ojousima/kon-41.3131/README.md

# kon-41.3131
Aalto university student project for constant temperature controller
