ojousima/kon-41.3131/TSYS01-shield/tsys01.kicad_pcb

## KiCad design TSYS01-shield/tsys01.kicad_pcb (2015-07-23)

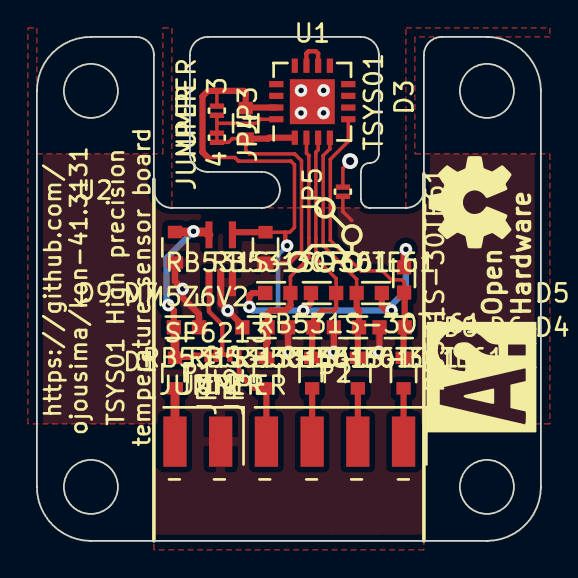
[picture p1: board tsys01.kicad_pcb from above]

Board: 2 copper layers, 28.0 x 28.0 mm, 26 parts (0 on the bottom side), 14 nets.

Parts:
C1, C2: 2u2; SMD0603_WAVE
C3: 100n; SMD0603_WAVE
D1: MM5Z6V2; SOD-523
D2, D3, D4, D5, D6, D7, D8, D9: RB531S-30TE61; SOD-523
JP1, JP2, JP3, JP4, JP5: JUMPER; R_0201
P1: CONN_01X02; Pin_Header_Angled_SMD_1x02
P2: CONN_01X04; Pin_Header_Angled_SMD_1x04
R1, R2, R3, R4, R5: 220; SMD0603_WAVE
U1: TSYS01; QFN-16-1EP_4x4mm_Pitch0.65mm
U2: SP6213; SC70-6_Handsoldering

Connections:
+3V3: C2.1, C3.1, D3.2, D5.2, D7.2, D9.2, JP3.1, U1.15, U2.4
/CS: JP2.2, P2.4, R2.1
/EN: D8.2, D9.1, R2.2, U1.2
/MISO: P2.1, R5.1
/MOSI: P2.2, R4.1
/PAD: JP5.2, U1.17
/SCLK: P2.3, R3.1
/Vin: C1.1, D1.2, JP1.1, JP1.2, JP2.1, R1.1, U2.1, U2.5
GNDA: C1.2, C2.2, C3.2, D1.1, D2.1, D4.1, D6.1, D8.1, JP3.2, JP4.1, JP4.2, JP5.1, P1.1, U1.1, U1.16, U2.2, U2.3
unnamed: D2.2, D3.1, R5.2, U1.5
unnamed: D4.2, D5.1, R4.2, U1.4
unnamed: D6.2, D7.1, R3.2, U1.3
unnamed: P1.2, R1.2
unnamed: U1.10, U1.11
