ojousima/kon-41.3131/adapter_board/adapter.kicad_pcb

## KiCad design adapter_board/adapter.kicad_pcb (2015-07-23)

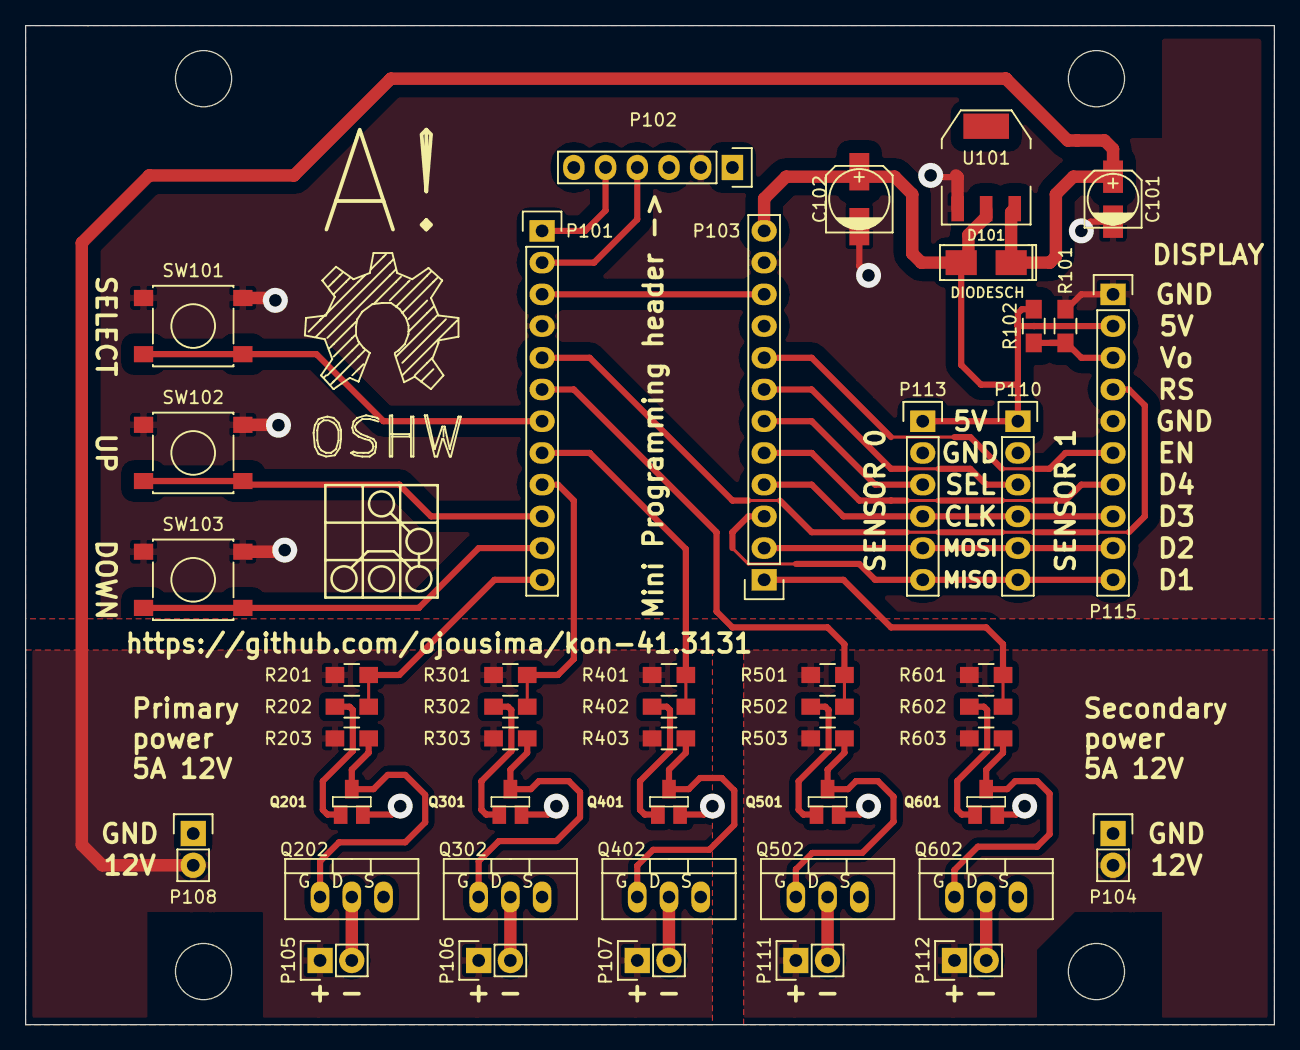
[picture p2: board adapter.kicad_pcb from above]

Board: 2 copper layers, 100.0 x 80.0 mm, 48 parts (0 on the bottom side), 39 nets.

Parts:
C101: 10u; c_elec_4x5.3
C102: 100u; c_elec_5x5.8
D101: DIODESCH; SMA_WAVE
LOGO101: OPEN_HARDWARE_2; Symbol_OSHW-Logo_SilkScreen_BIG
P101, P103: CONN_01X12; Pin_Header_Straight_1x12
P102, P110, P113: CONN_01X06; Pin_Header_Straight_1x06
P104, P105, P106, P107, P108, P111, P112: CONN_01X02; Pin_Header_Straight_1x02
P115: CONN_01X10; Pin_Header_Straight_1x10
Q201, Q301, Q401, Q501, Q601: BC850; SOT23EBC
Q202, Q302, Q402, Q502, Q602: IRF530N; TO-220_FET-GDS_Vertical
R101, R102: R; R_0805_HandSoldering
R201, R203, R301, R303, R401, R403, R501, R503, R601, R603: 10k; R_0805_HandSoldering
R202, R302, R402, R502, R602: 1k; R_0805_HandSoldering
SW101, SW102, SW103: SPST; SW_SPST_PTS645
U101: LD1117S50TR; SOT-223

Connections:
/5V: C102.1, D101.1, P103.12, P110.1, P113.1, P115.2, R101.1, U101.2
/BT0: P101.7, SW101.2
/BT1: P101.10, SW102.2
/BT2: P101.11, SW103.2
/D4: P103.5, P115.7
/MISO: P103.3, P110.6, P113.6, P115.10
/MOSI: P103.2, P110.5, P113.5, P115.9
/PWM0/12V: C101.1, D101.2, P105.1, P106.1, P107.1, P108.2, R201.1, R203.1, R301.1, R303.1, R401.1, R403.1, U101.3
/PWM0/Drain: P105.2, Q202.D
/PWM0/INV_PWM: P101.12, R201.2, R202.2
/PWM1/Drain: P106.2, Q302.D
/PWM1/INV_PWM: P101.9, R301.2, R302.2
/PWM2/Drain: P107.2, Q402.D
/PWM2/INV_PWM: P101.8, R401.2, R402.2
/PWM3/12V: P104.2, P111.1, P112.1, R501.1, R503.1, R601.1, R603.1
/PWM3/Drain: P111.2, Q502.D
/PWM3/INV_PWM: P101.6, R501.2, R502.2
/PWM4/Drain: P112.2, Q602.D
/PWM4/INV_PWM: P103.1, R601.2, R602.2
/RESET: P101.3, P103.10
/RS: P101.5, P115.4
/RXI: P101.2, P102.4
/SCLK: P103.4, P110.4, P113.4, P115.8
/SEL0: P103.6, P113.3
/SEL1: P103.7, P110.3
/SEL2: P103.8, P115.6
/TXO: P101.1, P102.5
/Vo: P115.3, R101.2, R102.1
GND: C101.2, C102.2, P101.4, P102.2, P103.11, P104.1, P108.1, P110.2, P113.2, P115.1, P115.5, Q201.1, Q202.S, Q301.1, Q302.S, Q401.1, Q402.S, Q501.1, Q502.S, Q601.1, Q602.S, R102.2, SW101.1, SW102.1, SW103.1, U101.1
unnamed: Q201.2, R202.1
unnamed: Q201.3, Q202.G, R203.2
unnamed: Q301.2, R302.1
unnamed: Q301.3, Q302.G, R303.2
unnamed: Q401.2, R402.1
unnamed: Q401.3, Q402.G, R403.2
unnamed: Q501.2, R502.1
unnamed: Q501.3, Q502.G, R503.2
unnamed: Q601.2, R602.1
unnamed: Q601.3, Q602.G, R603.2
