ojousima/kon-41.3131/adapter_board/adapter_panelized.kicad_pcb

## KiCad design adapter_board/adapter_panelized.kicad_pcb (2015-03-29)

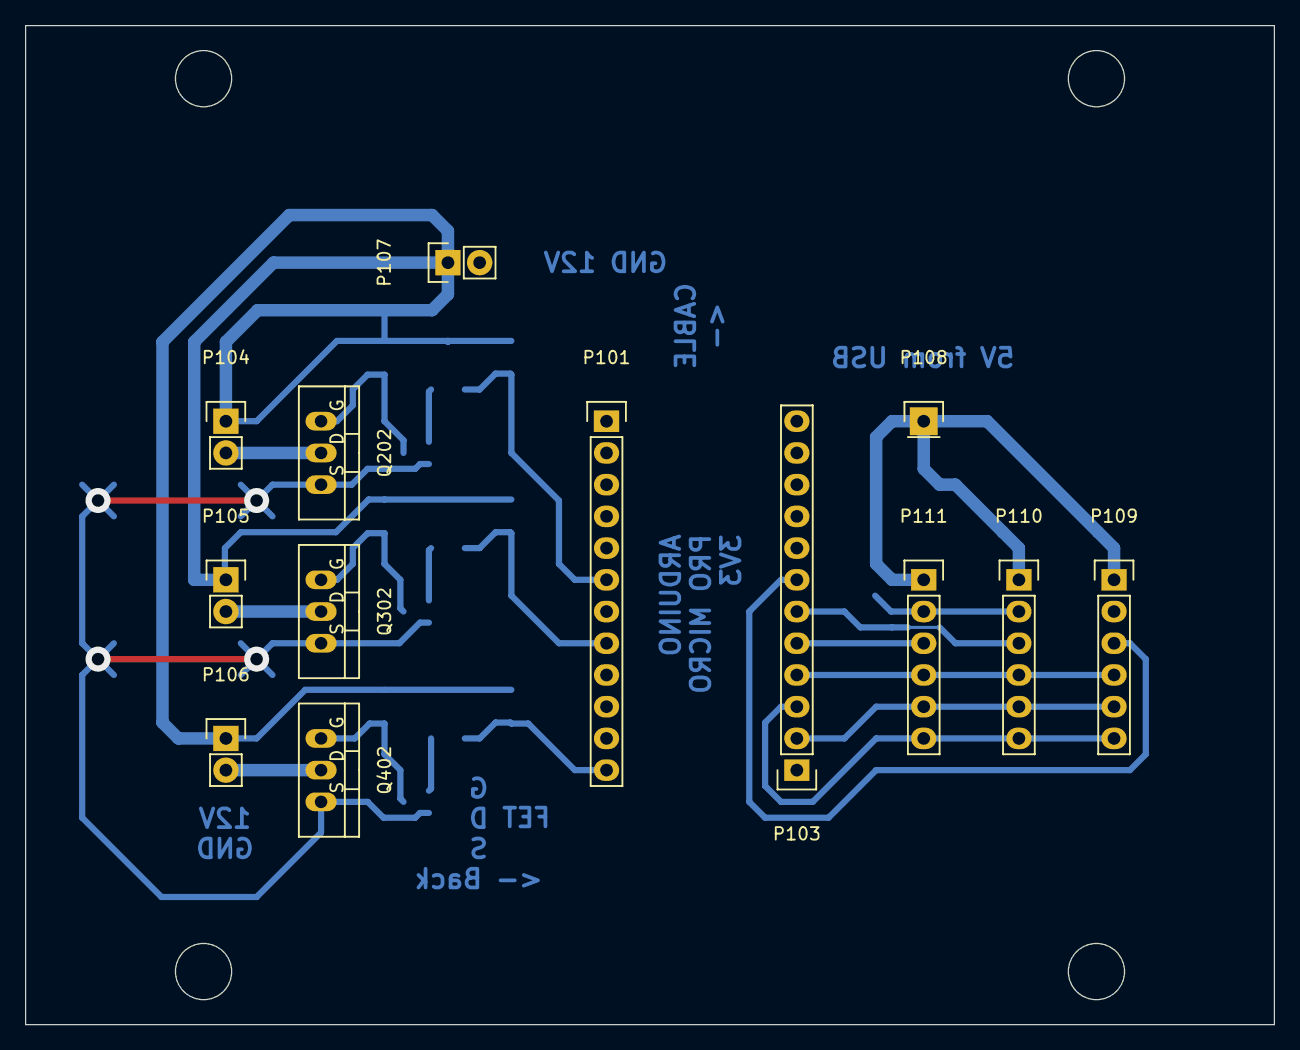
[picture p3: board adapter_panelized.kicad_pcb from above]

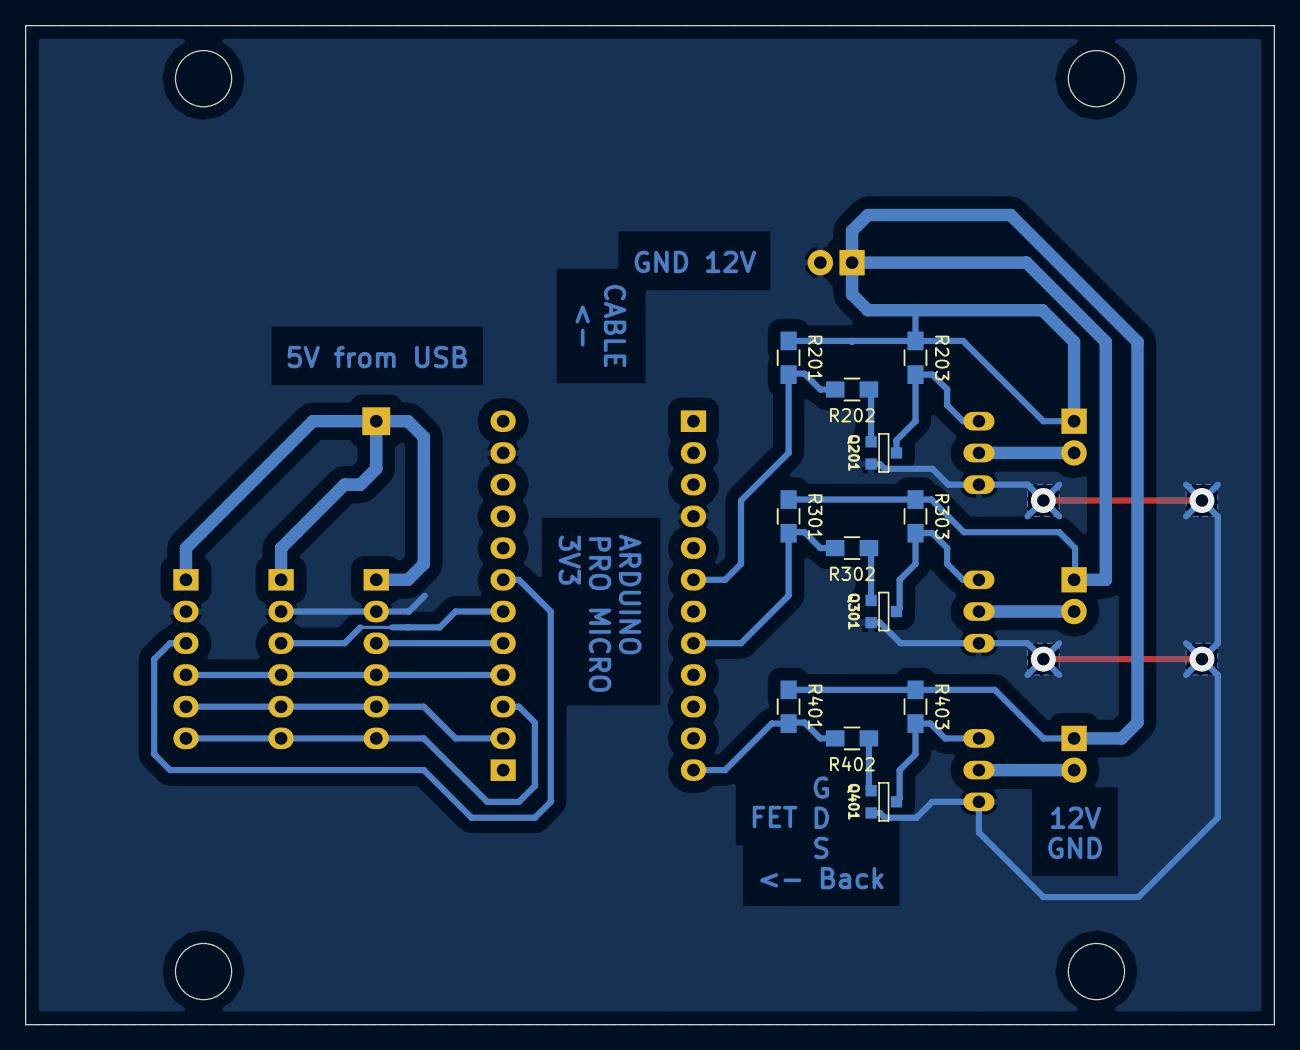
[picture p4: board adapter_panelized.kicad_pcb from below]

Board: 2 copper layers, 100.0 x 80.0 mm, 25 parts (12 on the bottom side), 21 nets.

Parts:
P101, P103: CONN_01X12; Pin_Header_Straight_1x12
P104, P105, P106, P107: CONN_01X02; Pin_Header_Straight_1x02
P108: CONN_01X01; Pin_Header_Straight_1x01
P109, P110, P111: CONN_01X06; Pin_Header_Straight_1x06
Q201, Q301, Q401: BC850; SOT23EBC
Q202, Q302, Q402: IRF530N; TO-220_FET-GDS_Vertical
R201, R203, R301, R303, R401, R403: 10k; R_0805_HandSoldering
R202, R302, R402: 1k; R_0805_HandSoldering

Connections:
/5V: P108.1, P109.1, P110.1, P111.1
/MISO: P103.3, P109.6, P110.6, P111.6
/MOSI: P103.2, P109.5, P110.5, P111.5
/PWM0/12V: P104.1, P105.1, P106.1, P107.1, R201.1, R203.1, R301.1, R303.1, R401.1, R403.1
/PWM0/Drain: P104.2, Q202.D
/PWM0/GND: P101.4, P103.11, P107.2, P109.2, P110.2, P111.2, Q201.1, Q202.S, Q301.1, Q302.S, Q401.1, Q402.S
/PWM0/INV_PWM: P101.6, R201.2, R202.2
/PWM1/Drain: P105.2, Q302.D
/PWM1/INV_PWM: P101.8, R301.2, R302.2
/PWM2/Drain: P106.2, Q402.D
/PWM2/INV_PWM: P101.12, R401.2, R402.2
/SCLK: P103.4, P109.4, P110.4, P111.4
/SEL0: P103.5, P111.3
/SEL1: P103.6, P110.3
/SEL2: P103.7, P109.3
unnamed: Q201.2, R202.1
unnamed: Q201.3, Q202.G, R203.2
unnamed: Q301.2, R302.1
unnamed: Q301.3, Q302.G, R303.2
unnamed: Q401.2, R402.1
unnamed: Q401.3, Q402.G, R403.2
