ojousima/kon-41.3131/(commit log)

2015-01-30 add gedit & kicad backup files to gitignore
2015-01-30 Add first draft of TSYS01 PCB
    [tsys01.kicad_pcb, tsys01.sch]
2015-02-08 First production version
    [tsys01.kicad_pcb, tsys01.sch]
2015-02-08 Add heater PCB
    [heater.kicad_pcb]
2015-02-08 Fix jumper connection
    [tsys01.kicad_pcb, tsys01.sch]
2015-02-09 Fix ground of connector
    [tsys01.kicad_pcb, tsys01.sch]
2015-03-23 Fix buffer overflow
    Fixes buffer overflow, calculation is now done correctly. Caveat emptor
    - not tested on real hardware
    [tsys01.ino]
2015-03-29 6 ohm nominal version of heater board
    [heater.kicad_pcb]
2015-03-29 First version of arduino adapter board
    [PWM.sch, adapter.kicad_pcb, adapter.sch, adapter_panelized.kicad_pcb]
2015-04-01 Add PID control
2015-05-05 Add display, 3 pushbuttons, 2 PWM channels
    [PWM.sch, adapter.sch]
2015-05-31 enlargen pads for handsoldering
    [PWM.sch, adapter.kicad_pcb, adapter.sch]
2015-07-23 Final version
    [PWM.sch, adapter.kicad_pcb, adapter.sch, tsys01.kicad_pcb, tsys01.sch]
